eSpark-Backup/benjamin-rcct-led-board-hw/Design-Files/Main-Controller-Board-v1.2.0/Deliverables/_Renderings/Isometric View.png

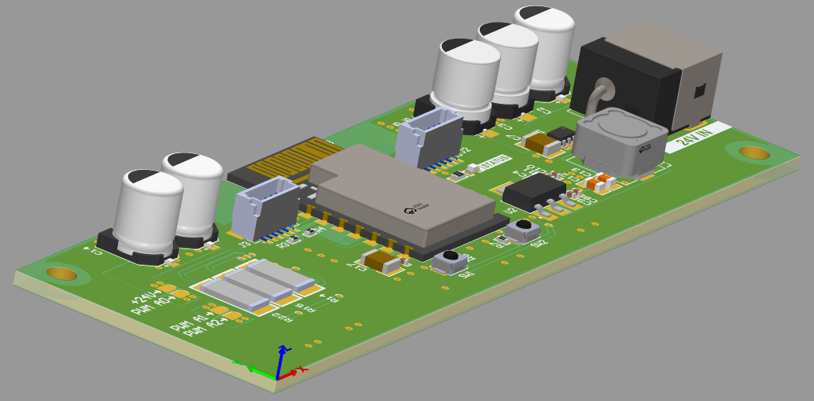
Design-Files/Main-Controller-Board-v1.2.0/Deliverables/_Renderings/Isometric View.png
