eSpark-Backup/benjamin-rcct-led-board-hw/Design-Files/Termination-Board-v1.0.1/Deliverables/_Renderings/Termination-Board-v1.0.1-2D.PNG

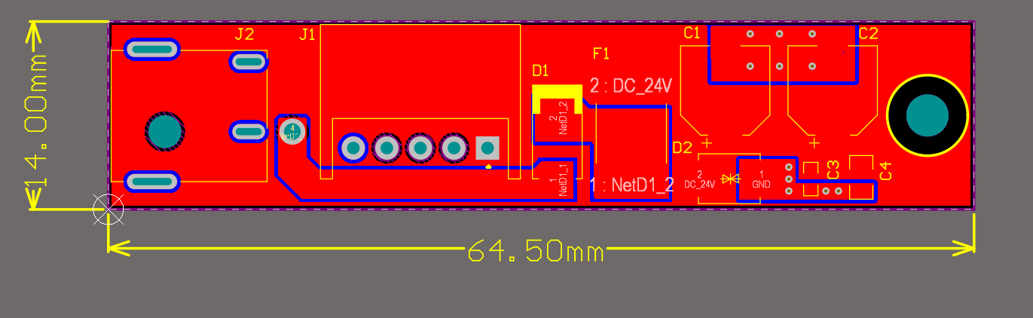
Design-Files/Termination-Board-v1.0.1/Deliverables/_Renderings/Termination-Board-v1.0.1-2D.PNG
