eSpark-Backup/benjamin-rcct-led-board-hw/Design-Files/Main-Controller-Board-v1.2.0/BOM/Client-BOM_Main-Controller-Board-v1.2.0.xlsx

# | Item Type | Designator | Description | Footprint | Manufacturer Part Number | Manufacturer | Value | Quantity | Remarks
1 |  | C1, C11 | CAP CER 0.1UF 50V X7R 0402 | Cap-0402 | CL05B104KB54PNC | Samsung | 0.1uF | 2
2 | Capacitor | C2, C3 | 47uF 50V 66mA@120Hz ±20% SMD,D6.3xL7.7mm Aluminum Electrolytic Capacitors - SMD ROHS | Custom | RVT1H470M0607 | ROQANG | 47uF | 2
3 | Capacitor | C4, C12, C13 | CAP CER 22UF 10V X5R 0805 | Cap-0805 | GRM21BR61A226ME44L | Murata | 22uF | 3
4 | Capacitors | C5 | CAP CER 0.1UF 50V X7R 0603 | Cap-0603 | CC0603JRX7R9BB104 | Yageo | 0.1uF | 1
5 |  | C6 | CAP CER 1UF 100V X7S 0805 | Cap-0805 | GCM21BC72A105KE36L | Murata | 1uF | 1
6 | Capacitor | C7 | Multilayer Ceramic Capacitors MLCC - SMD/SMT 1210 10uF 63volts *Derate Voltage/Temp | Cap-1210 | GRM32ER71J106KA12L | Murata | 10uF | 1
7 |  | C8 | CAP CER 4.7UF 10V X5R 0402 | Cap-0402 | CC0402KRX5R6BB475 | Yageo | 4.7uF | 1
8 | Capacitor | C9, C10, C16 | CAP CER 1UF 16V X5R 0402 | Cap-0402 | CC0402KRX5R7BB105 | Yageo | 1uF | 3
9 | Capacitors | C14, C15, C18 | 220uF 35V 600mA@100KHz 160mΩ@100KHz ±20% SMD,D6.3xL7.7mm Aluminum Electrolytic Capacitors - SMD ROHS | Custom | 189RV0019 | KNSCHA | 220uF | 3
10 | Capacitors | C17 | CAP CER 10UF 25V X7R 1210 | Cap-1210 | C3225X7R1E106M250AC | TDK Corporation | 10uF | 1
11 | Diode | D1 | SCHOTTKY DIODE SMB 100V 5A | SMB_ | SS510B | MDD | - | 1
12 | Diode | D2 | SMB(DO-214AA) TVS ROHS | SMB Bi Directional | SMBJ26CA | MSKSEMI | - | 1
13 | Fuse | F1 | 30V 3.3A 40A 6.6A 2920 Resettable Fuses ROHS | Fuse-2920 | BSMD2920-330-30V | BHFUSE | - | 1
14 | DC Power Connectors | J1 | Bend insert DC Power Receptacle -30℃~+85℃ 2.5mm 6mm 7A 24V Plugin DC Power Connectors ROHS | Custom | DC-044K-D025 | G-Switch | - | 1
15 | Connector | ~~J2~~ | ~~1x6P SH 1 1mm 6 SMD,P=1mm Wire To Board / Wire To Wire Connector ROHS~~ | ~~Custom~~ | ~~C145963~~ | ~~BOOMELE~~ | ~~DNP~~ | ~~1~~ | Do Not Place
16 | Connector | J3 | 1x6P SH 1 1mm 6 SMD,P=1mm Wire To Board / Wire To Wire Connector ROHS | Custom | C145963 | BOOMELE | - | 1
17 | Inductor | L1 | 2.26A 4.7uH ±20% SMD,7.3x7.3mm Power Inductors ROHS | Custom | YPRH0703-4R7M | YJYCOIN | 4.7uH | 1
18 | LED | LED1 | RED LED 0603 Light Emitting Diodes | LED-0603 | NCD0603R3 | Foshan NationStar Optoelectronics | - | 1
19 | Transistors | Q1, Q2, Q3, Q4, Q7, Q9 | TRANS NPN 65V 0.1A SOT23-3 | SOT-23 | BC846B-7-F | Diodes | - | 6
20 | Transistors | Q5, Q6, Q11 | 65V 200mW 220@2mA,5V 100mA PNP SOT-23 Bipolar Transistors - BJT ROHS | SOT-23 | BC856B | Guangdong Hottech | - | 3
21 | MOSFETs | Q8, Q10, Q12 | MOSFET N-CH 55V 12A SOT223 | SOT- 223 | BUK9832-55A/CUX | Nexperia | - | 3
22 | Resistors | R3, R4 | RES 0 OHM JUMPER 1/16W 0402 | Res-0402 | RC0402FR-070RL | Yageo | 0R | 2
23 |  | R5, R12, R13, R20 | RES 470 OHM 1% 1/10W 0603 | Res-0603 | RC0603FR-07470RL | Yageo | 470R | 4
24 | Resistor | R6 | RES 22 OHM 1% 1/16W 0402 | Res-0402 | RC0402FR-0722RL | Yageo | 22R | 1
25 | Resistor | R7 | RES 2K OHM 1% 1/16W 0402 | Res-0402 | RC0402FR-072KL | Yageo | 2K | 1
26 | Resistor | R8, R9, R10, R11, R16, R17 | RES 4.7K OHM 1% 1/16W 0402 | Res-0402 | RC0402FR-074K7L | Yageo | 4.7K | 6
27 | Resistor | R14, R15, R22 | 1W Thick Film Resistors 200V ±100ppm/℃ ±1% 51Ω 2512 Chip Resistor - Surface Mount ROHS | RES-2512 | FRC2512F51R0TS | FOJAN | 51R | 3
28 | Resistor | R18, R19, R21 | RES 10K OHM 1% 1/16W 0402 | Res-0402 | RC0402FR-0710KL | Yageo | 10K | 3
29 | Switch | SW1, SW2 | SWITCH TACTILE SPST-NO 0.05A 12V | B3U-1000P | B3U-1000P | Omron | - | 2
30 | IC | U1 | IC REG BUCK 5V 2A TSOT26 | TSOT-23-6 | AP63205WU-7 | Diodes | - | 1
31 | IC | U2 | SOT-223 Linear Voltage Regulators (LDO) ROHS | SOT- 223 | AMS1117-3.3 | GUOXIN JIAPIN SEMICONDUCTOR | - | 1
32 | WiFi Module | U3 | -90dBm 16dBm RTL8720DN Chip On-Board PCB Antenna 2.4GHz SMD,16x24mm WiFi Modules ROHS | BW16 | BW16 | Ai-Thinker | - | 1
33 | Optoisolators | U5, U6, U7 | SOP-8 Logic Output Optoisolators ROHS | SOP-8 (S Type) | 6N137S | UMW | - | 3
