eSpark-Backup/benjamin-rcct-led-board-hw/Design-Files/Termination-Board-v1.0.1/Deliverables/BOM/Client_BOM_Termination-Board-V1.0.1.xlsx

# | Item Type | Designator | Description | Footprint | Manufacturer Part Number | Manufacturer | Value | Quantity | Remarks
1 | Capacitor | C1, C2 | 47uF 50V 66mA@120Hz ±20% SMD,D6.3xL7.7mm Aluminum Electrolytic Capacitors - SMD ROHS | Custom | RVT1H470M0607 | ROQANG | 47uF | 2
2 | Capacitor | C3 | CAP CER 0.1UF 50V X7R 0603 | Cap-0603 | CC0603JRX7R9BB104 | Yageo | 0.1uF | 1
3 | Capacitor | C4 | CAP CER 1UF 100V X7S 0805 | Cap-0805 | GCM21BC72A105KE36L | Murata | 1uF | 1
4 | Diode | D1 | SCHOTTKY DIODE SMB 100V 5A | SMB | SS510B | MDD | - | 1
5 | Diode | D2 | SMB(DO-214AA) TVS ROHS | SMB Bi Directional | SMBJ26CA | MSKSEMI | - | 1
6 | Fuse | F1 | 30V 3.3A 40A 6.6A 2920 Resettable Fuses ROHS | Fuse-2920 | BSMD2920-330-30V | BHFUSE | - | 1
7 | Connector | J1 | CONN HEADER R/A 5POS 2.5MM | Custom | S5B-XH-A(LF)(SN) | JST | - | 1
8 | Connector | J2 | Bend insert DC Power Receptacle -30℃~+85℃ 2.5mm 6mm 7A 24V Plugin DC Power Connectors ROHS | Custom | DC-044K-D025 | G-Switch | - | 1
