eSpark-Backup/benjamin-rcct-led-board-hw/Design-Files/Main-Controller-Board-v1.2.0/Deliverables/_Supporting Files/Main-Controller-Board-PCB.step

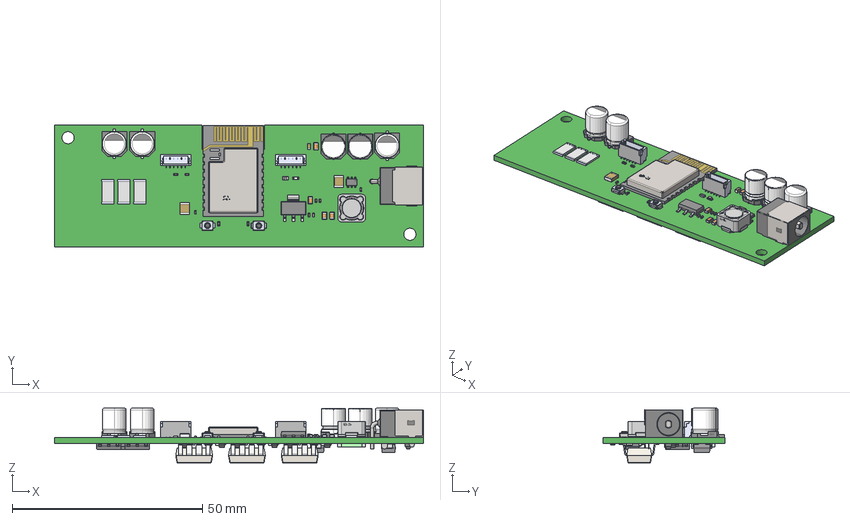
[picture p7: CAD file, 2025-04-04]
Design-Files/Main-Controller-Board-v1.2.0/Deliverables/_Supporting Files/Main-Controller-Board-PCB.step
97.0 x 32.0 x 14.4 mm
CircuitWorks-SOT-23 x 9
User Library-RESC1608X05N x 4
User Library-Capacitor 0402 x 6
User Library-0805 SMD Capacitor x 4
User Library-Fuse 2920
User Library-DO-214AA SMB x 2
User Library-SOT-223-1 x 4
User Library-TSOT-23-6(S6)
User Library-OMRON B3U1000P x 2
CircuitWorks-RESISTOR 2512 x 3
User Library-RES_1005-0402 x 13
User Library-LED SMD0603
SOLID.step.STEP.dwg.STEP.STEP.dwg x 2
User Library-CAPC3225X10 x 2
User Library-CAPC1608X09
