eSpark-Backup/benjamin-rcct-led-board-hw/Design-Files/Termination-Board-v1.0.1/Deliverables/_Supporting Files/Termination-Board-v1.0.1-PCB.step

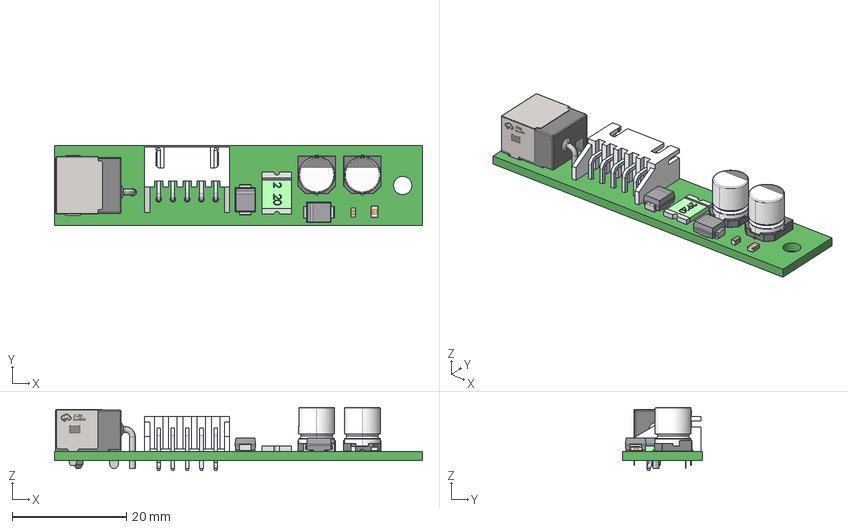
[picture p8: CAD file, 2024-11-25]
Design-Files/Termination-Board-v1.0.1/Deliverables/_Supporting Files/Termination-Board-v1.0.1-PCB.step
64.5 x 14.0 x 11.1 mm
SxB-XH-Axxxxx_5
pin^S5B-XH-A_bent x 2
pin^S5B-XH-A x 3
User Library-Fuse 2920
User Library-DO-214AA SMB x 2
User Library-0805 SMD Capacitor
User Library-CAPC1608X09
