eSpark-Backup/benjamin-rcct-led-board-hw/(list of files, cad)

Other CAD files:
Design-Files/Main-Controller-Board-v1.2.0/Deliverables/_Supporting Files/Main-Controller-Board-PCB.DWG
Design-Files/Main-Controller-Board-v1.2.0/Deliverables/_Supporting Files/Main-Controller-Board-PCB.DXF
Design-Files/Termination-Board-v1.0.1/Deliverables/_Supporting Files/Termination-Board-v1.0.1-PCB.DWG
Design-Files/Termination-Board-v1.0.1/Deliverables/_Supporting Files/Termination-Board-v1.0.1-PCB.DXF
