eSpark-Backup/benjamin-rcct-led-board-hw/Design-Files/Main-Controller-Board-v1.2.0/Deliverables/_Schematics/Main-Controller-Board-v1.2.0.pdf

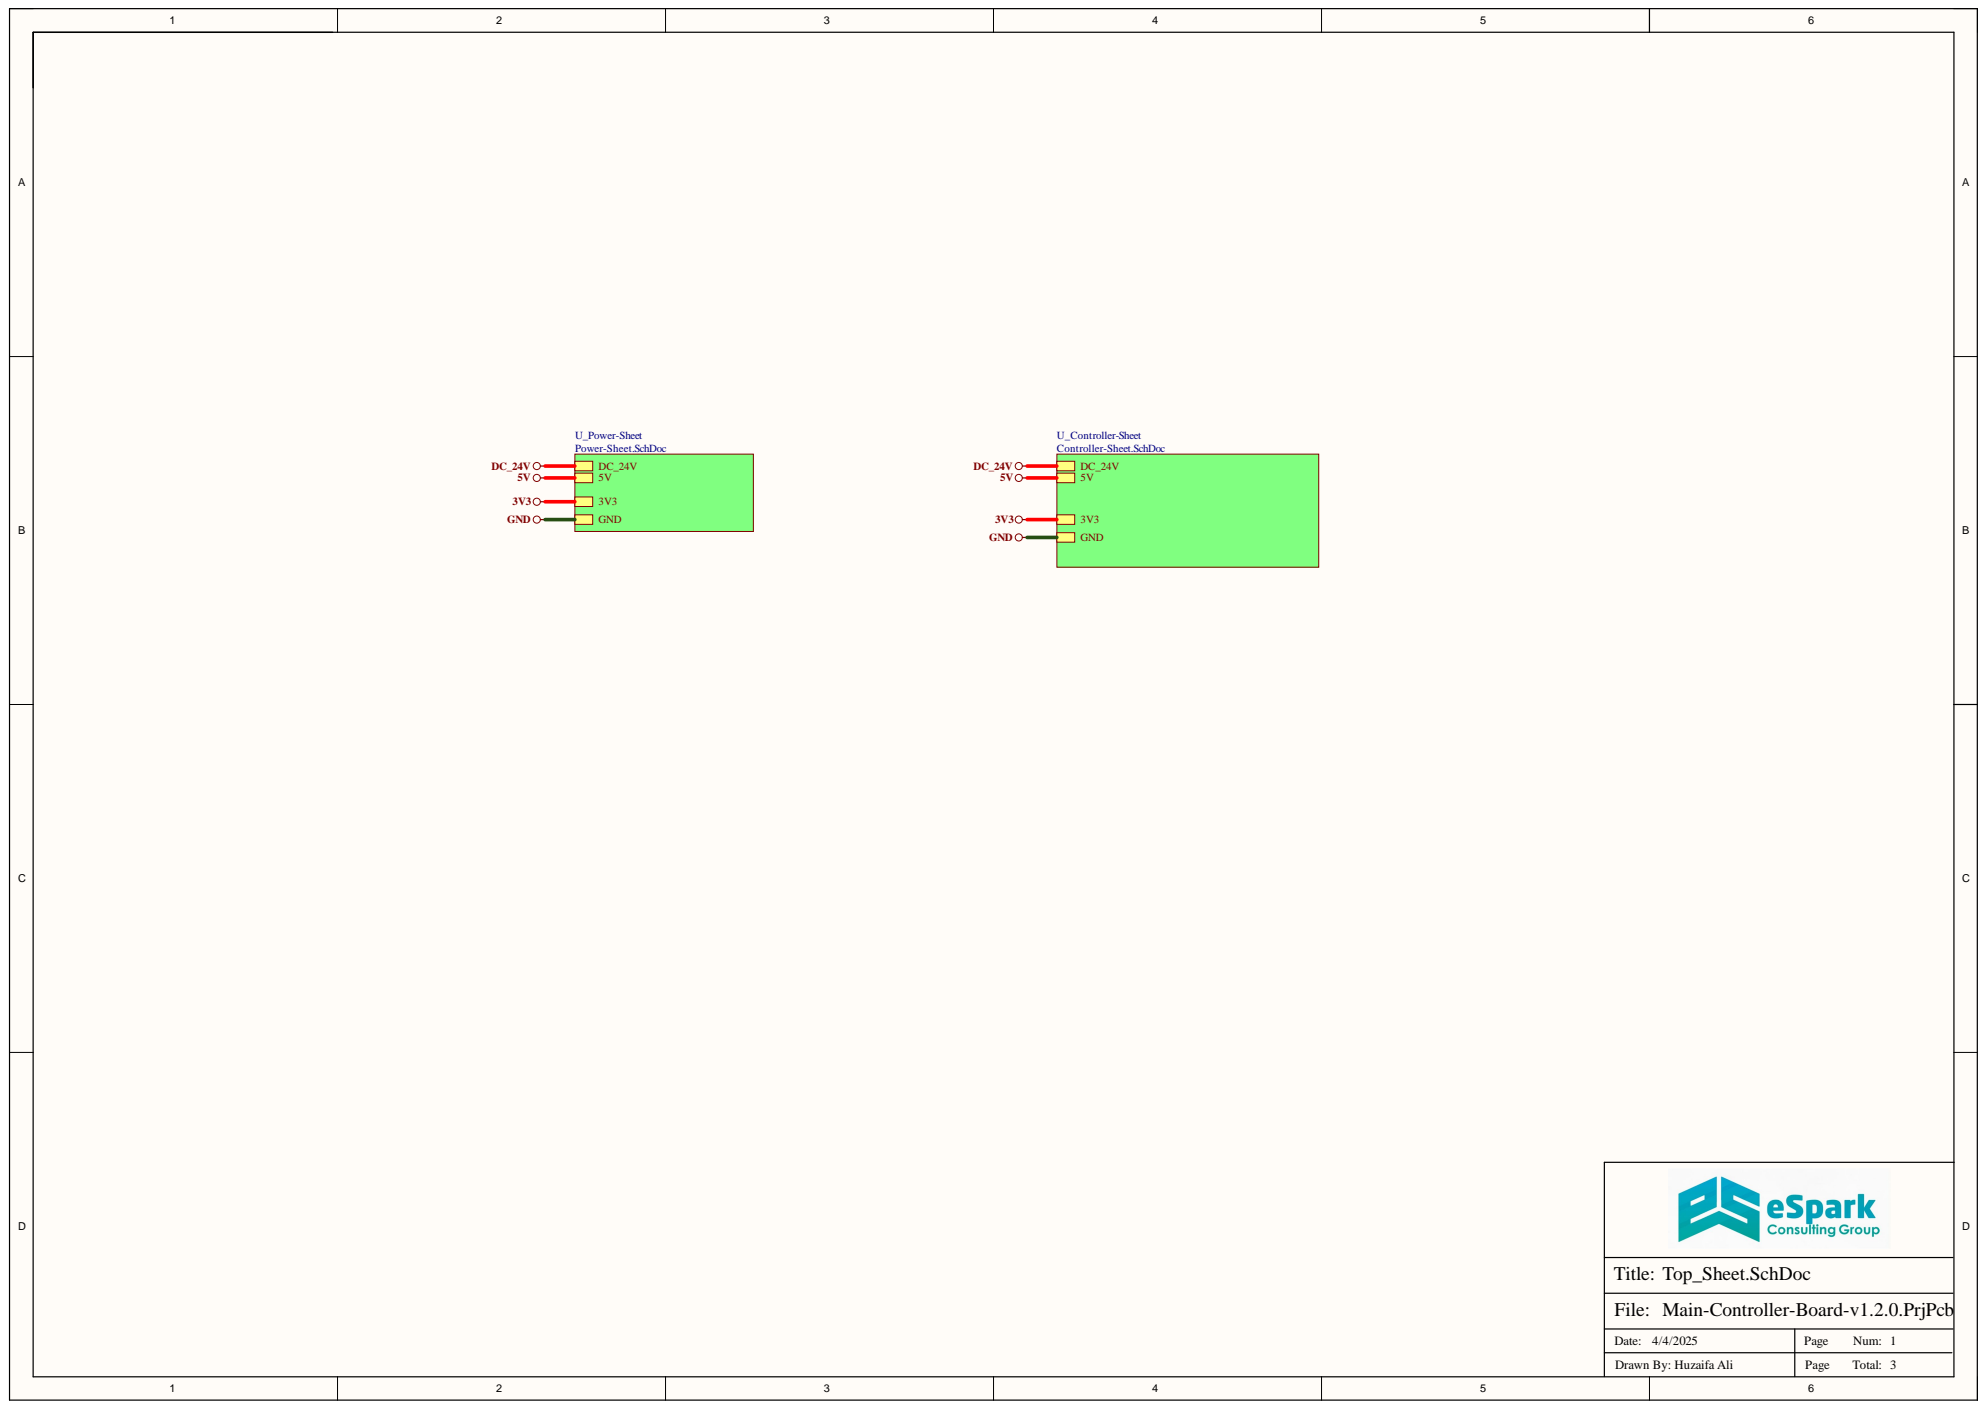
[picture p23: page 1]

Main-Controller-Board-v1.2.0.PrjPcb

Date: 4/4/2025 | Page Num: 1

Drawn By: Huzaifa Ali | Page Total:

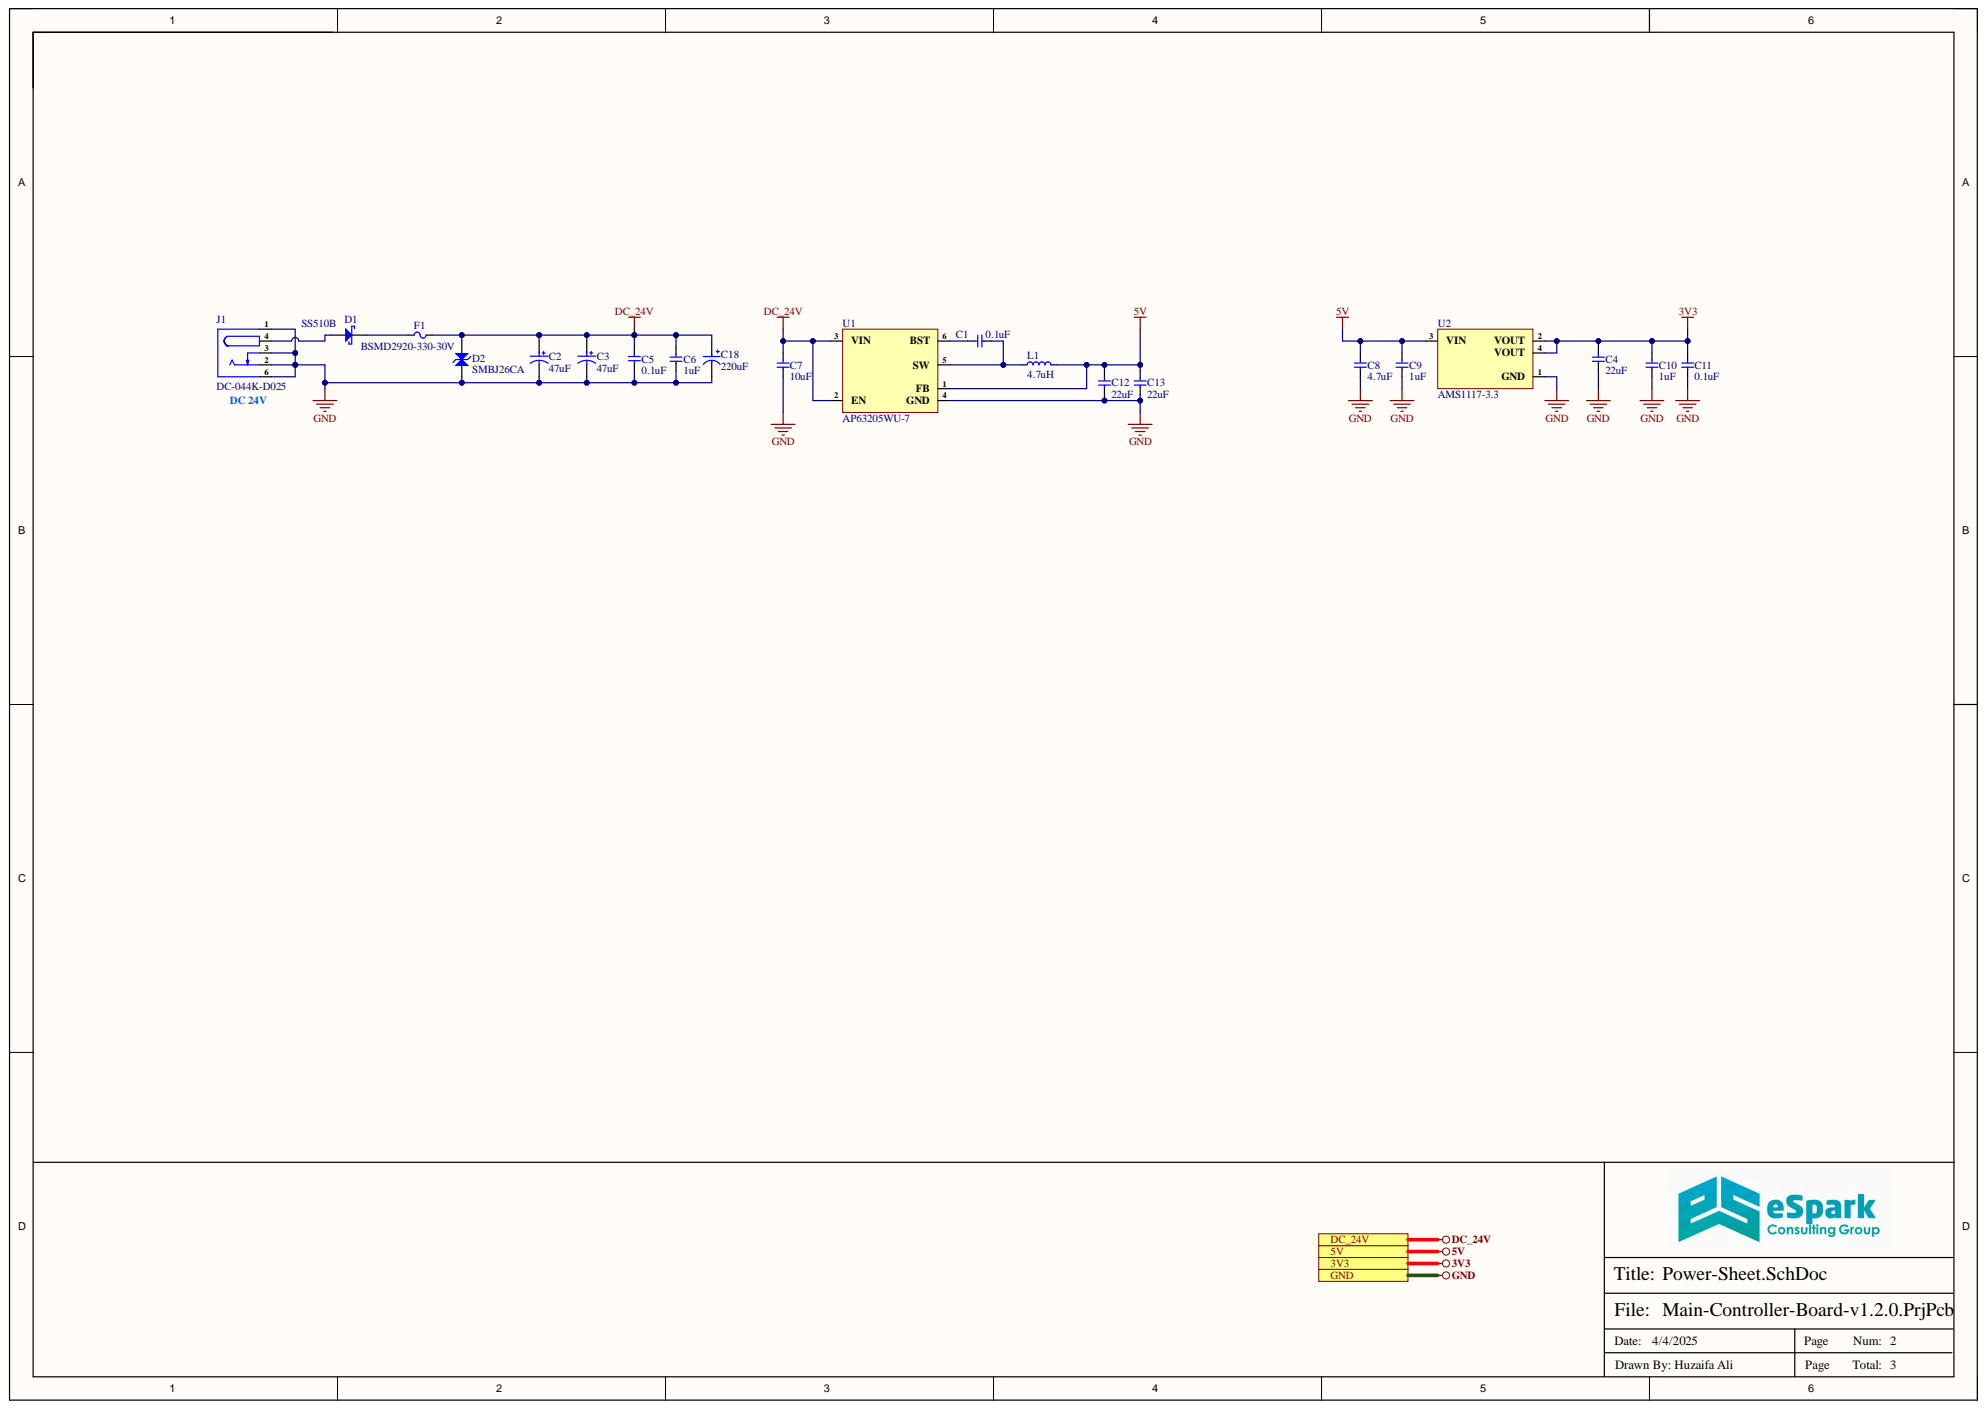
[picture p24: page 2]

Main-Controller-Board-v1.2.0.PrjPcb

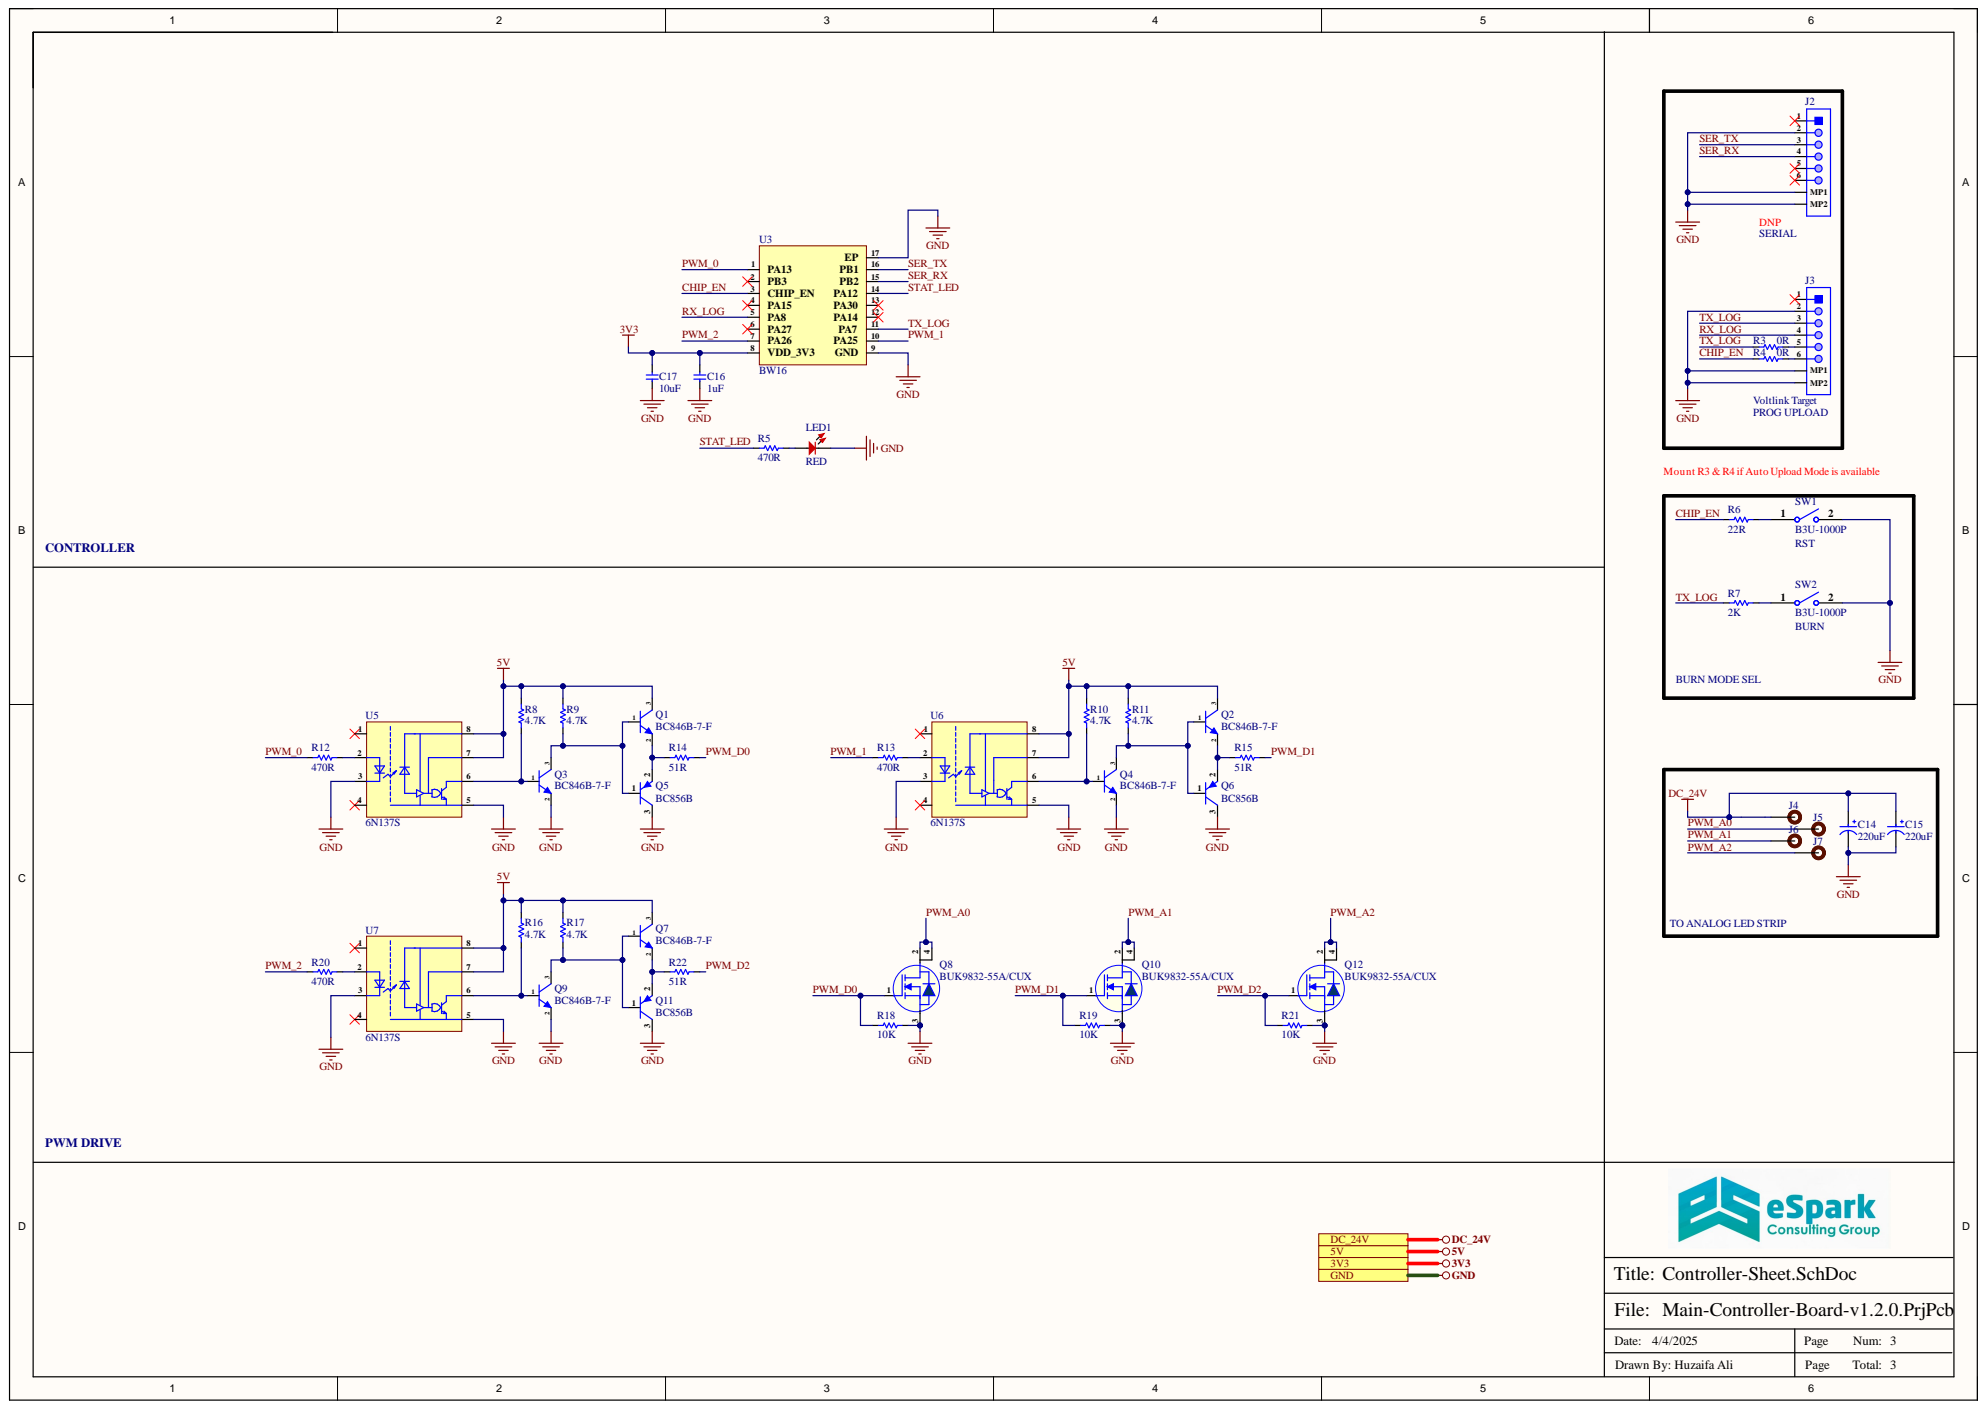
[picture p25: page 3]

Mount R3 & R4 if Auto Upload Mode is available

TO ANALOG LED STRIP

Main-Controller-Board-v1.2.0.PrjPcb
