eSpark-Backup/benjamin-rcct-led-board-hw/Design-Files/Termination-Board-v1.0.1/Schematic/Termination-Board-V1.0.1.pdf

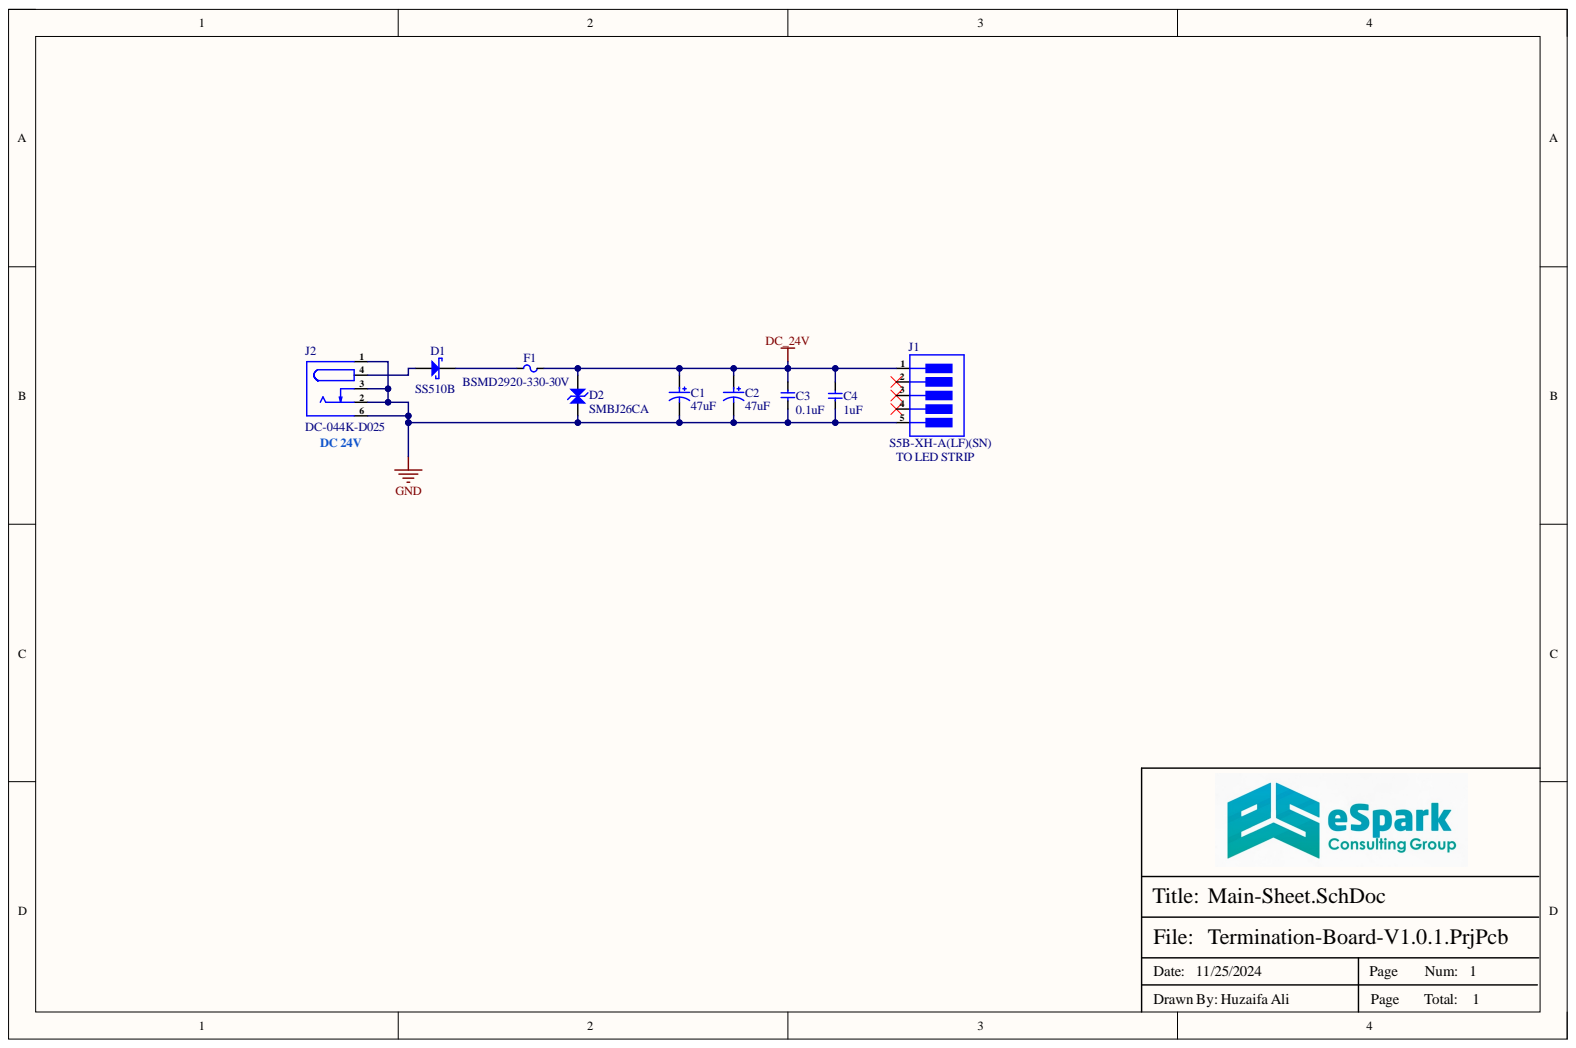
[picture p26: page 1]

Dat e : 1 1 / 2 5 / 2 0 2 4 | Pag e N u m : 11

D raw n B y : H uzai fa A l i | Pag e To t al :
