eSpark-Backup/benjamin-rcct-led-board-hw/Design-Files/Main-Controller-Board-v1.2.0/Deliverables/_Schematics/Assembly Drawing.pdf

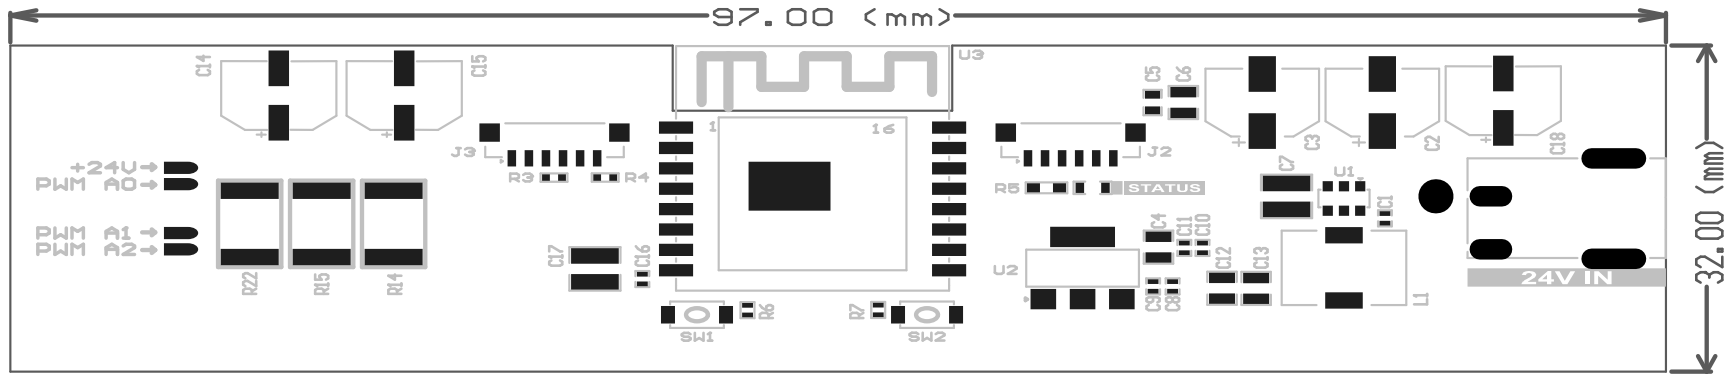
[picture p27: page 1]

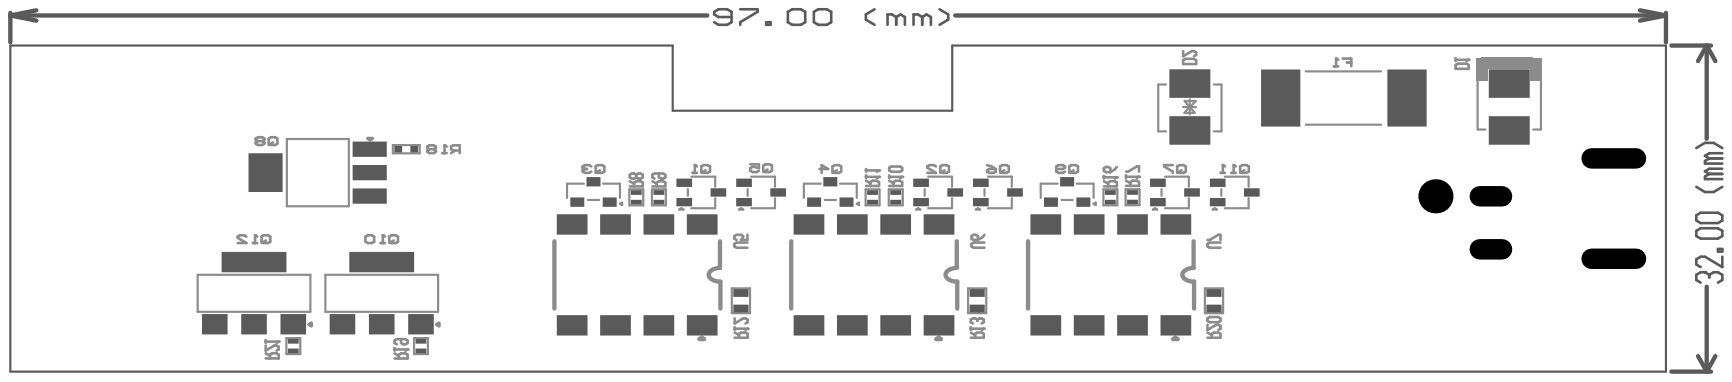
[picture p28: page 2]
