eSpark-Backup/benjamin-rcct-led-board-hw/(list of files, drawings)

Other design files:
Design-Files/Main-Controller-Board-v1.2.0/Controller-Sheet.SchDoc
Design-Files/Main-Controller-Board-v1.2.0/Main-Controller-Board-PCB.PcbDoc
Design-Files/Main-Controller-Board-v1.2.0/Main-Controller-Board-v1.2.0.PrjPcb
Design-Files/Main-Controller-Board-v1.2.0/Power-Sheet.SchDoc
Design-Files/Main-Controller-Board-v1.2.0/Top_Sheet.SchDoc
Design-Files/Termination-Board-v1.0.1/Main-Sheet.SchDoc
Design-Files/Termination-Board-v1.0.1/Termination-Board-v1.0.1-PCB.PcbDoc
Design-Files/Termination-Board-v1.0.1/Termination-Board-V1.0.1.PrjPcb
