eSpark-Backup/benjamin-rcct-led-board-hw/(commit log)

2024-11-04 #1 Added Top_Sheet, Power_Sheet, Controller_Sheet, PDF generated
    [Controller-Sheet.SchDoc, Main-Controller-Board-v1.0.0.PrjPcb, Power-Sheet.SchDoc, Top_Sheet.SchDoc]
2024-11-05 #1 Net Name updated in power sheet
    [Power-Sheet.SchDoc]
2024-11-06 #1 Controller-Sheet updated, D3 removed, F2 & F3 added, Q8 Q10 & Q12 added
    [Controller-Sheet.SchDoc, Main-Controller-Board-v1.0.0.PrjPcb, Power-Sheet.SchDoc, Top_Sheet.SchDoc]
2024-11-07 #1 5-Pin JST Connector added, Termination-Board added
    [Controller-Sheet.SchDoc, Main-Controller-Board-v1.0.0.PrjPcb, Main-Sheet.SchDoc, Power-Sheet.SchDoc, Termination-Board-V1.0.0.PrjPcb]
2024-11-07 Folder structure updated; gitignore added
    [Main-Sheet.SchDoc, Termination-Board-V1.0.0.PrjPcb]
2024-11-08 #1 Termination-Board Placement done, Main-Controller-Board In progress
    [Controller-Sheet.SchDoc, Main-Controller-Board-PCB.PcbDoc, Main-Controller-Board-v1.0.0.PrjPcb, Main-Sheet.SchDoc, Power-Sheet.SchDoc, Termination-Board-V1.0.0.PrjPcb, Termination-Board-v1.0.0-PCB.PcbDoc]
2024-11-11 #1 Main-Controller-Board-PCB placement done, Termination Board placement done.
    [Controller-Sheet.SchDoc, Main-Controller-Board-PCB.PcbDoc, Main-Controller-Board-v1.0.0.PrjPcb, Termination-Board-v1.0.0-PCB.PcbDoc]
2024-11-12 #1 Main-Controller-Board-PCB Routing in progress
    [Controller-Sheet.SchDoc, Main-Controller-Board-PCB.DWG.DWG, Main-Controller-Board-PCB.DXF, Main-Controller-Board-PCB.PcbDoc, Main-Controller-Board-PCB.step, Main-Sheet.SchDoc, Power-Sheet.SchDoc, Termination-Board-v1.0.0-PCB.PcbDoc]
2024-11-12 #1 Termination Board, DXF/DEG, Step file added
    [Main-Controller-Board-PCB.DWG, Main-Controller-Board-PCB.DWG.DWG, Main-Controller-Board-PCB.DXF, Main-Controller-Board-PCB.PcbDoc, Main-Controller-Board-PCB.step, Termination-Board-v1.0.0-PCB.DWG, Termination-Board-v1.0.0-PCB.DXF, Termination-Board-v1.0.0-PCB.PcbDoc]
2024-11-13 #1 Main-Controller-Board PCB updated, DXF / DWG, Step File updated
    [Controller-Sheet.SchDoc, Main-Controller-Board-PCB.DWG, Main-Controller-Board-PCB.DXF, Main-Controller-Board-PCB.PcbDoc, Main-Controller-Board-PCB.step, Power-Sheet.SchDoc]
2024-11-15 #1 Main-Controller-Board-PCB updated
    [Main-Controller-Board-PCB.DWG, Main-Controller-Board-PCB.DWG.DWG, Main-Controller-Board-PCB.DXF, Main-Controller-Board-PCB.PcbDoc, Main-Controller-Board-PCB.step, Main-Controller-Board-v1.0.0.PrjPcb]
2024-11-18 #1 Deliverables Updated
    [Centroid File.csv, Centroide File.csv, Client_BOM_Main-Controller-Board-v1.0.0.xlsx, Client_BOM_Termination-Board-V1.0.0.xlsx, Main-Controller-Board-PCB.DWG, Main-Controller-Board-PCB.DWG.DWG, Main-Controller-Board-PCB.DXF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]
2024-11-18 #2 JLCPCB BOM added.
    [JLCPCB-v1.0.0.xlsx]
2024-11-19 #1 Termination Board PCB Updated, Deliverables updated
    [Centroid File.csv, Pick Place for Termination-Board-v1.0.0-PCB.csv, Termination-Board-V1.0.0.PrjPcb, Termination-Board-v1.0.0-PCB.DWG, Termination-Board-v1.0.0-PCB.DXF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]
2024-11-19 #1 Gerber Files updated
2024-11-19 @faizi968 @SM-esprk Termination Board JLCPCB BOM added
    [JLCPCB-BOM-Termination-Board-V1.0.0.xlsx]
2024-11-21 #3 In Progress
    [Client_BOM_Main-Controller-Board-v1.1.0.xlsx, Client_BOM_Termination-Board-V1.0.1.xlsx, Controller-Sheet.SchDoc, JLCPCB-BOM-Termination-Board-V1.0.1.xlsx, JLCPCB-v1.1.0.xlsx, Main-Controller-Board-PCB.PcbDoc, Main-Controller-Board-v1.1.0.PrjPcb, Main-Sheet.SchDoc]
2024-11-22 #3 Main-Board & Termination-Board PCB Updated, Deliverables updated
    [Centroide File.csv, Client_BOM_Main-Controller-Board-v1.1.0.xlsx, Client_BOM_Termination-Board-V1.0.1.xlsx, Controller-Sheet.SchDoc, JLCPCB-BOM-Termination-Board-V1.0.1.xlsx, JLCPCB-v1.1.0.xlsx, Main-Controller-Board-PCB.DWG, Main-Controller-Board-PCB.DXF]
2024-11-22 Remove: Old version files #3
    [Centroid File.csv, Centroide File.csv, Client_BOM_Main-Controller-Board-v1.0.0.xlsx, Client_BOM_Termination-Board-V1.0.0.xlsx, Controller-Sheet.SchDoc, JLCPCB-BOM-Termination-Board-V1.0.0.xlsx, JLCPCB-v1.0.0.xlsx, Main-Controller-Board-PCB.DWG]
2024-11-22 #3 0.1uF CAP Part No. updated in BOM
    [Client_BOM_Main-Controller-Board-v1.1.0.xlsx, Client_BOM_Termination-Board-V1.0.1.xlsx, JLCPCB-BOM-Termination-Board-V1.0.1.xlsx, JLCPCB-v1.1.0.xlsx]
2024-11-25 #3 Termination_Board and Main_Controller_Board Schematic, PCB Updated, Deliverables Updated
    [Centroide File.csv, Client_BOM_Main-Controller-Board-v1.1.0.xlsx, Client_BOM_Termination-Board-V1.0.1.xlsx, JLCPCB-BOM-Termination-Board-V1.0.1.xlsx, JLCPCB-v1.1.0.xlsx, JLCPCB_BOM_Main-Controller-Board-v1.1.0.xlsx, Main-Controller-Board-PCB.DWG, Main-Controller-Board-PCB.DXF]
2024-11-26 #3 51Ohm (R14, R15, R22) Resistor part no updated in Main-Controller-Board, BOM Updated
    [Client_BOM_Main-Controller-Board-v1.1.0.xlsx, Controller-Sheet.SchDoc, JLCPCB_BOM_Main-Controller-Board-v1.1.0.xlsx, Main-Controller-Board-PCB.PcbDoc, Main-Controller-Board-v1.1.0.PrjPcb]
2025-03-26 #7 Updated component placement (in progress)
    [Controller-Sheet.SchDoc, Main-Controller-Board-PCB.PcbDoc, Main-Controller-Board-v1.1.0.PrjPcb]
2025-03-27 #7 Version updated to v1.2.0
    [Centroide File.csv, Client_BOM_Main-Controller-Board-v1.1.0.xlsx, Controller-Sheet.SchDoc, JLCPCB_BOM_Main-Controller-Board-v1.1.0.xlsx, Main-Controller-Board-PCB.DWG, Main-Controller-Board-PCB.DXF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]
2025-03-27 #7 Routing started
    [Main-Controller-Board-PCB.PcbDoc, Main-Controller-Board-v1.2.0.PrjPcb]
2025-03-28 #7 Design v1.2.0 completed. Deliverables generated
    [Centroid.csv, Centroide File.csv, Client-BOM_Main-Controller-Board-v1.2.0.xlsx, Client_BOM_Main-Controller-Board-v1.1.0.xlsx, Controller-Sheet.SchDoc, JLCPCB_BOM_Main-Controller-Board-v1.1.0.xlsx, Main-Controller-Board-PCB.DWG, Main-Controller-Board-PCB.DXF]
2025-03-28 Remove: v1.1.0 schematic PDF from v1.2.0 design
2025-04-04 #7 Changes Completed and deliverables Generated.
    [Centroid.csv, Client-BOM_Main-Controller-Board-v1.2.0.xlsx, Controller-Sheet.SchDoc, Main-Controller-Board-PCB.DWG, Main-Controller-Board-PCB.DXF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]
